Luneque/mobile_robot_2WD_ESP32/foto4.png

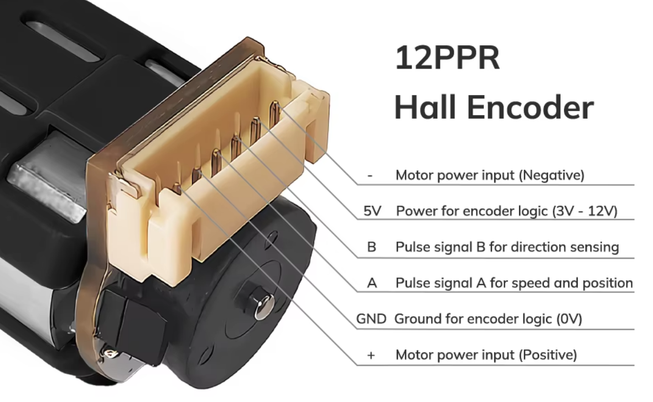
foto4.png
