Luneque/mobile_robot_2WD_ESP32/foto1.png

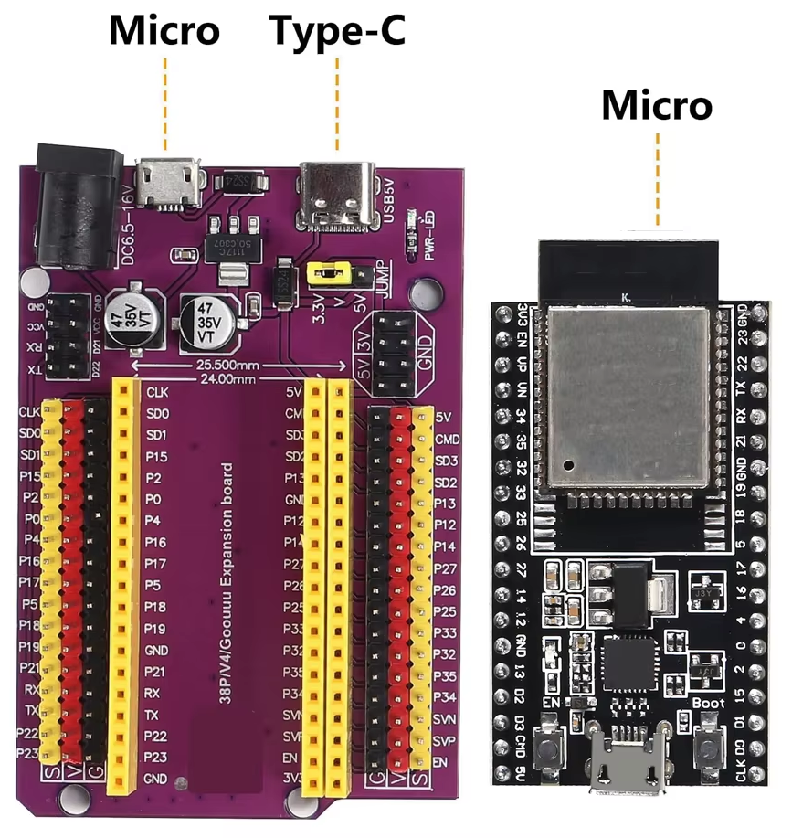
foto1.png
