Luneque/mobile_robot_2WD_ESP32/foto2.png

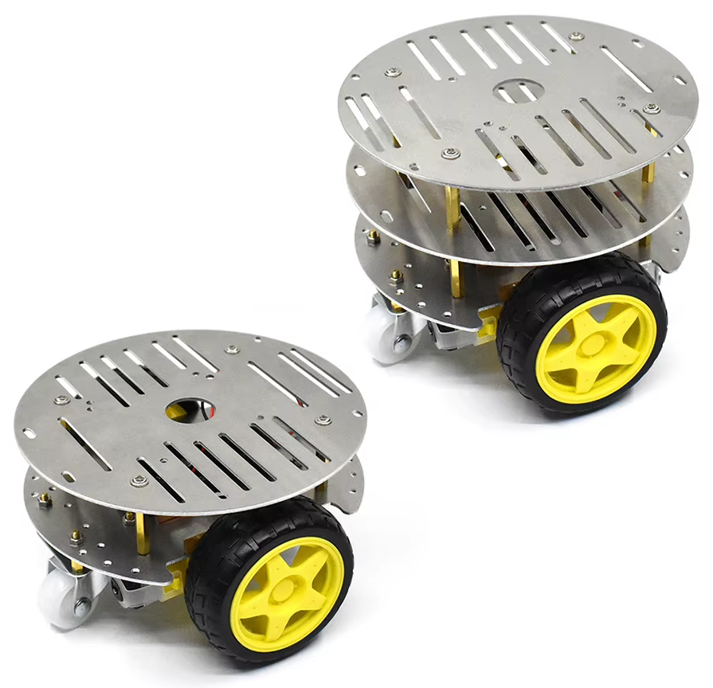
foto2.png
