Luneque/mobile_robot_2WD_ESP32/foto3.png

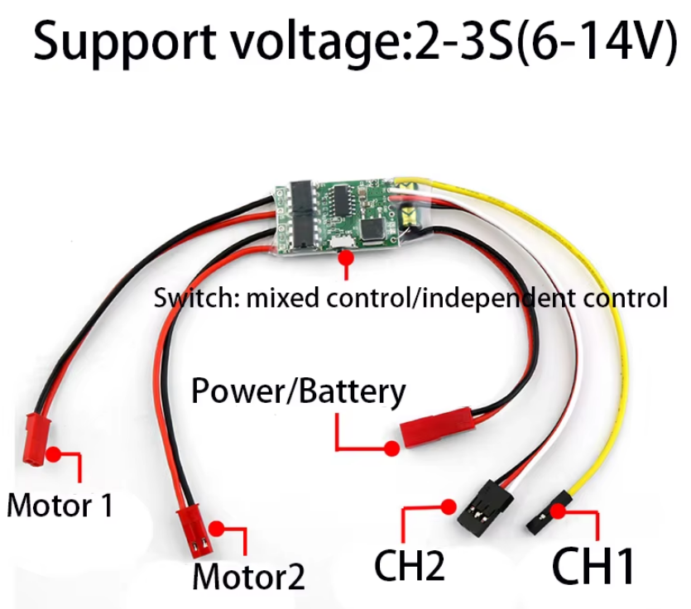
foto3.png
