Luneque/mobile_robot_2WD_ESP32/(commit log)

2026-11-09 feat: commit inicial do firmware robo diferencial 2WD com ESP32 (MCPWM + PCNT)
2026-11-10 fix(diag_pcnt): atualiza calculo de voltas para 4320 pulsos por volta
    [diag_pcnt.ino]
2026-11-10 feat: implementa versao 3 com arquitetura robusta, watchdog, rampa trapezoidal e maquina de estados nao-bloqueante
2026-11-10 perf(v3): eleva velocidade de cruzeiro para 80 RPM e ajusta rampas trapezoidais
2026-11-10 fix(v3): reconfigura TWDT corretamente apos armamento do ESC e encurta rampas trapezoidais para ganho real de desempenho
    [config.h, firmware_robo2wd_v3.ino]
2026-11-10 docs: atualiza FSD v3.0, Manual, Diario e README; move V1 e V2 para legacy/
2026-11-10 refactor(pinout): remaneja encoder esquerdo para GPIO 16/17 liberando barramento I2C (GPIO 21/22) e GPIO 23
2026-11-10 feat: adiciona ferramenta de diagnostico e validacao I2C para IMU Bosch BMI160
2026-11-10 feat(imu): integra fusao sensorial com IMU Bosch BMI160 no firmware oficial V3
2026-11-10 fix(imu): inverte polaridade do eixo Z e ajusta ganho proporcional de rumo para estabilidade plena
    [config.h, imu_bmi160.h]
2026-11-11 fix(imu): corrige yawError relativo, aplica IMU_KP_PIVO no pivo e preserva sinal do yaw
    [calib_imu_polaridade.ino, config.h, firmware_robo2wd_v3.ino]
2026-11-11 docs: atualiza DIARIO, FSD, MANUAL, README e diag_encoders refletindo IMU BMI160 v3 completo
2026-11-11 fix(imu): remove g_yawRef redundante e corrige documentacao da IMU
    - Remove a variavel global g_yawRef: o resetYaw() ja zera o angulo no inicio de cada segmento, entao yawError = yawAtual.
    - Corrige DIARIO, FSD e MANUAL: calibrateGyro() com 150 amostras, update(float dt_sec) com dt em segundos, acelerometro +-2 g e nao lido pelo firmware (apenas o diag_i2c_bmi160 le).
    - Marca Ideia_robo.md como documento historico (pinout da V1, incompativel com a V3).
    [firmware_robo2wd_v3.ino]
2026-11-11 fix(imu): remove correcao de yaw do pivo (realimentacao positiva)
    - O termo sync_corr += yawError * IMU_KP_PIVO era aplicado em modo comum; em pivô isso nao altera a taxa de rotacao e causa translacao proporcional ao yaw.
    - Remove o macro IMU_KP_PIVO de config.h e atualiza FSD, Manual e Diario.
    - Verificado em bancada: robô suspenso completou a trajetoria; pivo usou o fallback de encoders (1.15x) com yaw 0.0, sem erros ou emergencias.
    [config.h, firmware_robo2wd_v3.ino]
2026-11-12 tune(v4): compensa zona morta estatica para 110us e reforca ganho de yaw/sync em retas
2026-11-12 docs: promove versao 4 para oficial, move versao 3 para legacy e documenta telemetria websocket
2026-11-12 fix(imu): corrige polaridade do eixo Z para convencao horario=positivo, adiciona secrets.example e alinha docs
    [firmware_robo2wd_v4.ino, imu_bmi160.h]
2026-11-12 refactor(v4): calibra cruzeiro para 55 RPM, ajusta corte de pivo para 89 deg, adiciona stop remoto e alinha docs
2026-11-12 docs: adiciona Etapa 9 ao diario, alinha corte de pivo para 89 deg e sincroniza tempos reais
2026-11-13 fix(v4): alinha cruzeiro para 40 RPM real, sincroniza tabela de parametros e historico v4.0 na FSD
    [config.h]
2026-11-13 fix(kinematics): calibra diametro de rodas para 66mm real e suaviza giro pivo para 35 RPM
    [config.h]
2026-11-13 fix(pivot+sync): guarda movimento minimo no pivo para evitar disparo por residuo IMU; aumenta K_SYNC 0.08->0.12 para corrigir drift M2>M1
    [config.h, firmware_robo2wd_v4.ino]
2026-11-13 feat(dashboard): adiciona mapa 2D de trajetoria real vs ideal e atualiza documentacao tecnica
2026-11-13 fix(control+odometry): corrige corte de pivo por delta real de yaw e odometria cumulativa no mapa
    [firmware_robo2wd_v4.ino, wifi_telemetry.h]
2026-11-13 fix(dashboard): corrige odometria do mapa 2D para renderizar os 4 lados do percurso
    [wifi_telemetry.h]
2026-11-13 fix(dashboard): ajusta geometria real exata do quadrado no mapa 2D
    [wifi_telemetry.h]
2026-11-13 fix(control+dashboard): alinha orientacao da seta no pivo e reforca controle giroscopico em reta
    [config.h, firmware_robo2wd_v4.ino, wifi_telemetry.h]
2026-11-13 docs: atualiza descrição de odometria, setas e ganhos de controle
2026-11-13 docs: consolida tabela de parametros com valores vigentes do firmware
    - FSD secao 5: K_SYNC 0.15, IMU_KP_YAW_RETA 2.0, tolerancia de corte do pivo 0,5 deg (89,5) e guarda MIN_TICKS_PIVO 200
    - FSD secao 2.2: cruzeiro 55 RPM nominal (~40 RPM real)
    - FSD secao 4.5: controle por delta real de yaw (g_yawStartSeg)
    - FSD secao 7 e blocos recentes: v4.0.0 com corte 89,5 deg; removidos blocos 'Atualizacoes Recentes' duplicados
    - MANUAL/DIARIO/README: propagados K_SYNC=0.15, IMU_KP_YAW_RETA=2.0, tolerancia 0,5 deg e roda 66 mm
2026-11-13 feat(diag): adiciona utilitario diag_motor_curve para curva PWM x RPM
    - diag_motor_curve: arma o ESC e varre PWM 1500-1850us medindo o RPM real dos dois motores via PCNT, saida em CSV
    - Permite decidir entre ajuste de PID (se 55 RPM <= 1850us) e recalibracao de ESC (se > 1850us)
    - README e Diario de Engenharia atualizados com o novo utilitario
